gj-prog2026/BalancingRobot/hardware/pcb_kicad_ref.png

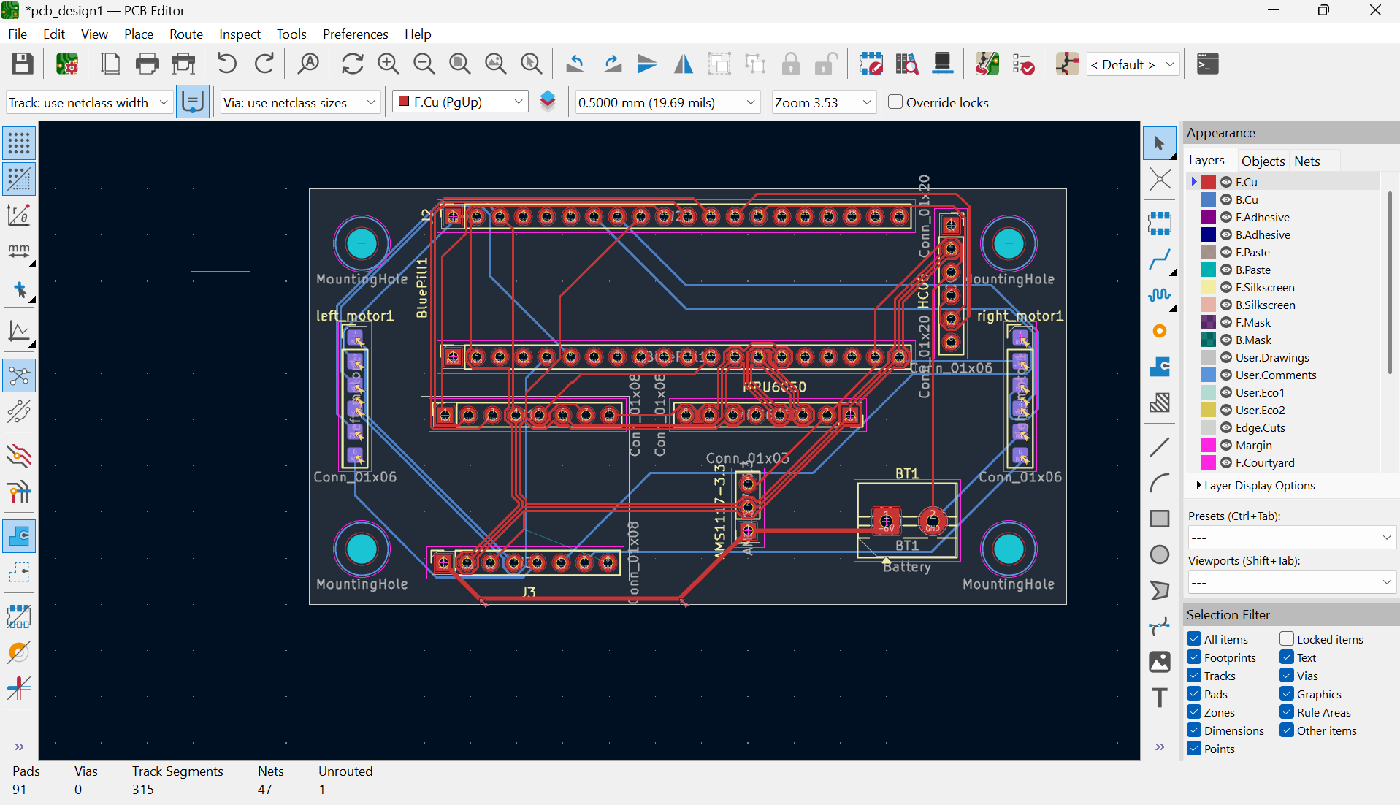
hardware/pcb_kicad_ref.png
