gj-prog2026/BalancingRobot/MATLAB_simulation/Screenshot 2026-10-11 233818.png

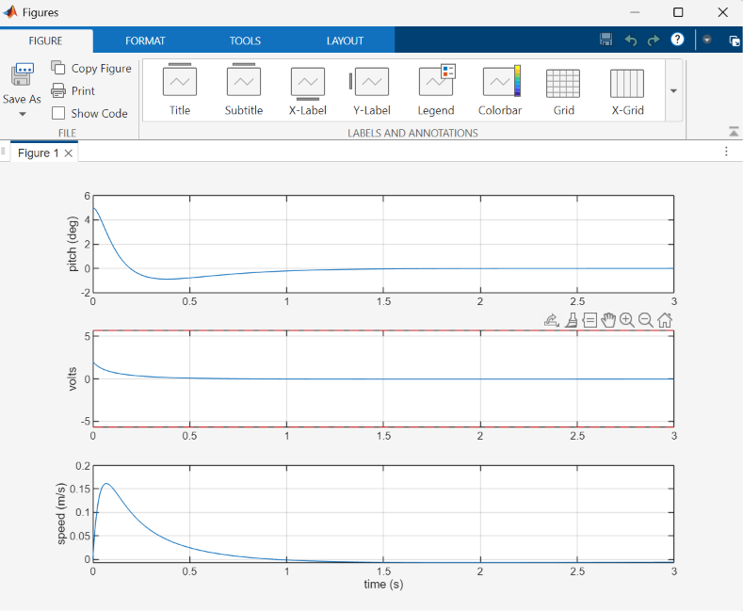
MATLAB_simulation/Screenshot 2026-10-11 233818.png
