gj-prog2026/BalancingRobot/MATLAB_simulation/Screenshot 2026-10-11 234223.png

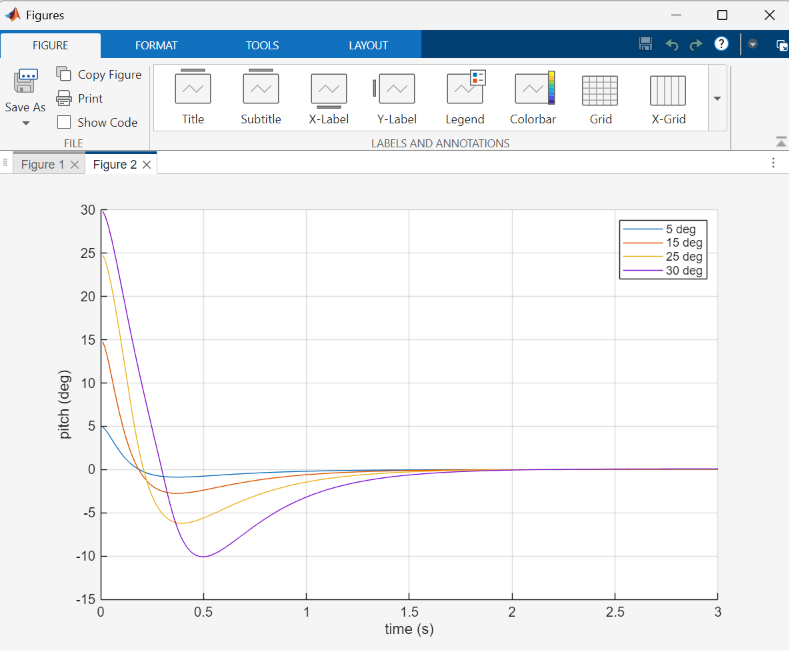
MATLAB_simulation/Screenshot 2026-10-11 234223.png
