gj-prog2026/BalancingRobot/hardware/3D_printing_parts/batt layer.stl

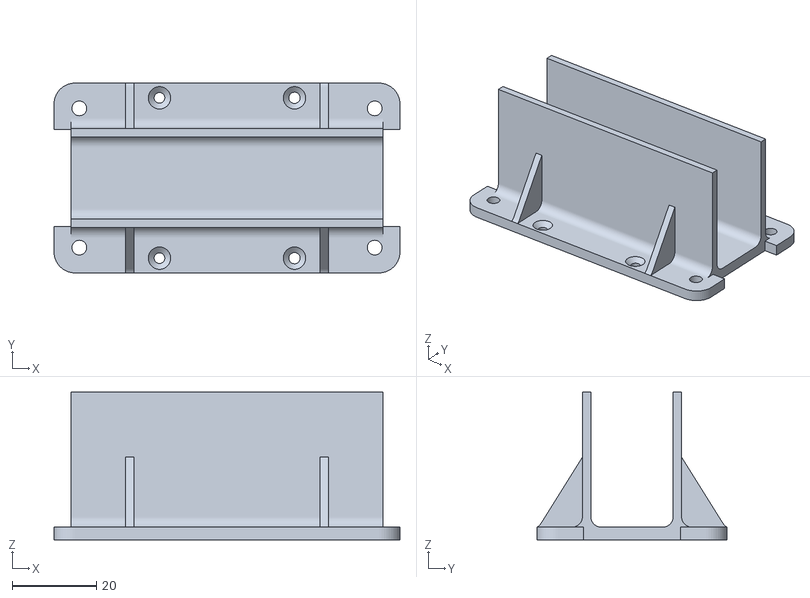
[picture p5: CAD file, 2026-09-17]
hardware/3D_printing_parts/batt layer.stl
82.0 x 45.0 x 35.0
