gj-prog2026/BalancingRobot/hardware/3D_printing_parts/base.stl

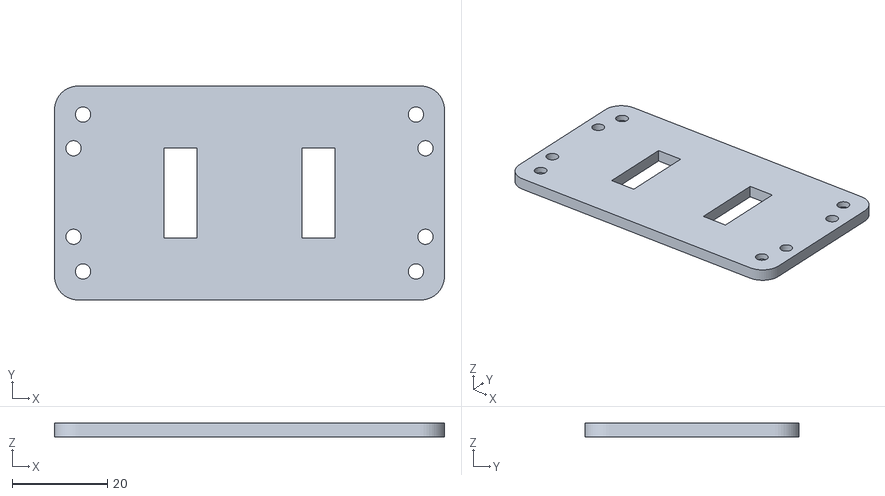
[picture p6: CAD file, 2026-09-17]
hardware/3D_printing_parts/base.stl
82.0 x 45.0 x 3.00
