gj-prog2026/BalancingRobot/hardware/3D_printing_parts/motor bracket 2.stl

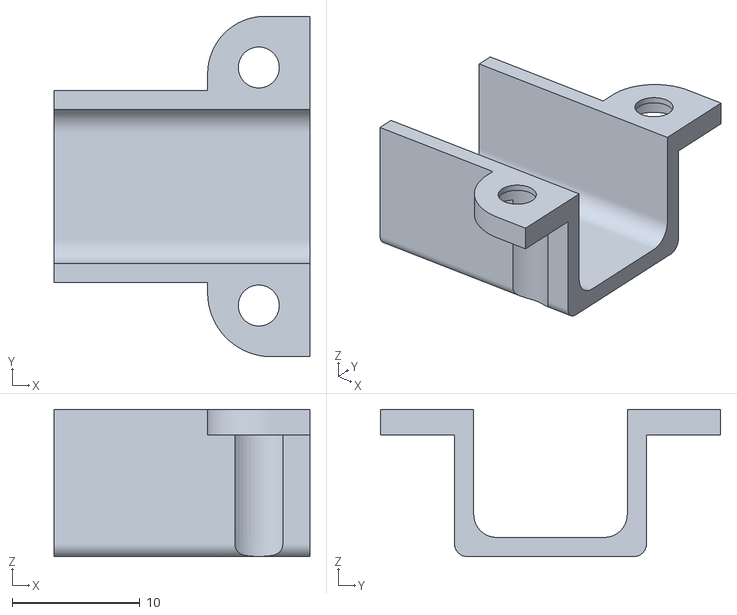
[picture p7: CAD file, 2026-09-17]
hardware/3D_printing_parts/motor bracket 2.stl
20.0 x 26.6 x 11.5
