gj-prog2026/BalancingRobot/(list of files, cad)

Other CAD files:
hardware/3D_printing_parts/motor bracket 3.stl
