gj-prog2026/BalancingRobot/software/tests_LQR/after_adjusting_gyro_accel_ratio/db_log_with_log_print1.txt

//first
LOG rel*100,acc*100,gyro*10,enc_d,pwm
8,-6,2,0,8
9,31,1,0,8
8,-98,-1,0,4
8,-66,-5,0,0
6,-71,-10,0,-6
5,-64,-15,0,-12
2,-59,-22,0,-22
-1,-170,-35,0,-39
-7,-301,-56,0,-65
-15,-368,-79,1,9976,8926,1515,-54,999
2134,-3077,1685,-52,999
2331,7513,1865,-53,999
2520,-7448,2086,-54,999
2736,-6265,2343,-54,999
2987,621,2557,-53,999
3282,8360,2847,-53,999
3605,7028,3158,-51,999
END

//second
LOG rel*100,acc*100,gyro*10,enc_d,pwm
-53,-87,-20,0,-59
-55,-67,-18,0,-59
-58,-478,-1-7870,-153,56,-999
-3058,-4318,-2330,55,-999
-3281,14402,-2584,55,-999
-3575,-7715,-2863,55,-999
-3842,16101,-3068,54,-999
-4177,-2583,-3380,55,-999
-4518,10090,-3706,55,-999
-4921,-4647,-4032,56,-999
END

//third
LOG rel*100,acc*100,gyro*10,enc_d,pwm
-358,-4001,1044,59,-878
-245,-1885,1162,60,-703
-94,9793,1317,59,-403
51,2073,1420,55,-71
196,-1702,1487,49-17189,-4251,52,-999
-3789,-8857,-4670,55,-999
-4383,-4466,-5939,58,-999
-4939,18688,-6039,61,-999
END

//forth
LOG rel*100,acc*100,gyro*10,enc_d,pwm
375,-1595,-560,7,-726
185,-5057,-1793,8,-999
-56,-4158,-2339,15,-999
-274,-3721,-2106,15,-999
-381,6146,-1202,24,-999
-452,-666,-704,28,-999
-480,-6332,-166,35,-999
-451,2560,234,38,-999
-418,-163,1449,-4,999
2239,-487,1618,-53,999
2411,-7200,1909,-55,999
2610,-1414,2076,-54,999
2842,6224,2246,-53,999
3061,-10298,2460,-54,999
3305,-12873,2760,-54,999
3613,7032,3013,-53,999
END

//fifth
LOG rel*100,acc*100,gyro*10,enc_d,pwm
-7,-26,-1,0,-7
-7,-28,-1,0,-6
-7,42,0,0,-5
-7,-182,2,0,-2
-6,-225,10,0,6
-4,-270,23,0,21
-1,-333,43,0,45
4,-451,68,0,76
13,-513,960 f307 d=595
r=-942 x=-94 v=0 p=0 f=

//conclusion: log os damaged with only 10 survivng lines to be used
// add the HAL_delay(20)
