gj-prog2026/BalancingRobot/software/tests_LQR/after_adjusting_gyro_freq/test.txt

r=-113 x=-216 v=8 p=-999 f=0 o=677 d=10
r=-82 x=-215 v=9 p=196 f=0 o=677 d=10
r=-98 x=-213 v=12 p=-768 f=0 o=677 d=10
r=-77 x=-212 v=25 p=-999 f=0 o=677 d=10
r=-67 x=-210 v=4 p=-315 f=0 o=677 d=10
r=-97 x=-209 v=23 p=-588 f=0 o=677 d=10
r=-84 x=-207 v=12 p=-878 f=0 o=677 d=10
r=-95 x=-206 v=20 p=-141 f=0 o=677 d=10
r=-60 x=-203 v=7 p=-999 f=0 o=677 d=10
r=-78 x=-201 v=28 p=136 f=0 o=677 d=10
r=-83 x=-199 v=29 p=-157 f=0 o=677 d=10
r=-76 x=-196 v=25 p=-999 f=0 o=677 d=10
r=-48 x=-193 v=34 p=-330 f=0 o=677 d=10
r=-19 x=-190 v=13 p=-167 f=0 o=677 d=10
r=-49 x=-187 v=32 p=-999 f=0 o=677 d=10
r=-41 x=-185 v=14 p=399 f=0 o=677 d=10
r=-67 x=-183 v=21 p=-999 f=0 o=677 d=10
r=-52 x=-182 v=13 p=586 f=0 o=677 d=10
r=-85 x=-180 v=18 p=-999 f=0 o=677 d=10
r=-42 x=-178 v=15 p=926 f=0 o=677 d=10
r=-53 x=-176 v=16 p=-781 f=0 o=677 d=10
r=-60 x=-175 v=10 p=82 f=0 o=677 d=10
r=-90 x=-173 v=18 p=-999 f=0 o=677 d=10
r=-78 x=-172 v=23 p=207 f=0 o=677 d=10
r=-82 x=-170 v=20 p=-999 f=0 o=677 d=10
r=-78 x=-169 v=14 p=60 f=0 o=677 d=10
r=-83 x=-167 v=26 p=-999 f=0 o=677 d=10
r=-83 x=-165 v=27 p=-919 f=0 o=677 d=10
r=-75 x=-163 v=26 p=-284 f=0 o=677 d=10
r=-54 x=-160 v=27 p=-999 f=0 o=677 d=10
r=-42 x=-158 v=19 p=-6 f=0 o=677 d=10
r=-57 x=-156 v=20 p=-999 f=0 o=677 d=10
r=-52 x=-154 v=14 p=468 f=0 o=677 d=10
r=-92 x=-151 v=32 p=-999 f=0 o=677 d=10
r=-56 x=-149 v=11 p=212 f=0 o=677 d=10
r=-74 x=-147 v=17 p=-999 f=0 o=677 d=10
r=-48 x=-144 v=15 p=-999 f=0 o=677 d=10
r=-70 x=-142 v=24 p=-123 f=0 o=677 d=10
r=-69 x=-140 v=16 p=-999 f=0 o=677 d=10
r=-37 x=-137 v=8 p=999 f=0 o=677 d=10
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
