gj-prog2026/BalancingRobot/software/tests_LQR/sign_test/result_log.txt

rel*10=956 gyro*10=0 pwm=0
rel*10=956 gyro*10=0 pwm=0
rel*10=956 gyro*10=2 pwm=0
rel*10=956 gyro*10=1 pwm=0
rel*10=956 gyro*10=0 pwm=0
rel*10=956 gyro*10=0 pwm=0
rel*10=956 gyro*10=0 pwm=0
rel*10=956 gyro*10=0 pwm=0
rel*10=956 gyro*10=0 pwm=0
rel*10=956 gyro*10=0 pwm=0
rel*10=956 gyro*10=0 pwm=0
rel*10=955 gyro*10=-4 pwm=0
rel*10=955 gyro*10=-5 pwm=0
rel*10=955 gyro*10=0 pwm=0
rel*10=955 gyro*10=1 pwm=0
rel*10=956 gyro*10=3 pwm=0
rel*10=956 gyro*10=5 pwm=0
rel*10=956 gyro*10=1 pwm=0
rel*10=956 gyro*10=0 pwm=0
rel*10=956 gyro*10=0 pwm=0
rel*10=956 gyro*10=-8 pwm=0
rel*10=956 gyro*10=1 pwm=0
rel*10=956 gyro*10=0 pwm=0
rel*10=955 gyro*10=1 pwm=0
rel*10=955 gyro*10=0 pwm=0
rel*10=956 gyro*10=0 pwm=0
rel*10=956 gyro*10=0 pwm=0
rel*10=956 gyro*10=0 pwm=0
rel*10=955 gyro*10=0 pwm=0
rel*10=955 gyro*10=0 pwm=0
rel*10=955 gyro*10=-2 pwm=0
rel*10=955 gyro*10=-9 pwm=0
rel*10=951 gyro*10=-70 pwm=0
rel*10=944 gyro*10=-8 pwm=0
rel*10=943 gyro*10=-10 pwm=0
rel*10=940 gyro*10=-76 pwm=0
rel*10=924 gyro*10=-174 pwm=0
rel*10=901 gyro*10=-318 pwm=0
rel*10=855 gyro*10=-544 pwm=0
rel*10=804 gyro*10=-514 pwm=0
rel*10=759 gyro*10=-491 pwm=0
rel*10=702 gyro*10=-543 pwm=0
rel*10=648 gyro*10=-528 pwm=0
rel*10=596 gyro*10=-527 pwm=0
rel*10=545 gyro*10=-518 pwm=0
rel*10=491 gyro*10=-546 pwm=0
rel*10=424 gyro*10=-714 pwm=0
rel*10=339 gyro*10=-779 pwm=0
rel*10=266 gyro*10=-598 pwm=0
rel*10=178 gyro*10=-865 pwm=0
rel*10=77 gyro*10=-857 pwm=0
rel*10=22 gyro*10=-317 pwm=0
rel*10=19 gyro*10=36 pwm=0
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
rel*10=313 gyro*10=463 pwm=0
rel*10=373 gyro*10=755 pwm=0
rel*10=466 gyro*10=925 pwm=0
rel*10=572 gyro*10=1058 pwm=0
rel*10=680 gyro*10=921 pwm=0
rel*10=776 gyro*10=887 pwm=0
rel*10=835 gyro*10=355 pwm=0
rel*10=865 gyro*10=288 pwm=0
rel*10=892 gyro*10=261 pwm=0
rel*10=932 gyro*10=1043 pwm=0
rel*10=912 gyro*10=35 pwm=0
rel*10=922 gyro*10=0 pwm=0
rel*10=929 gyro*10=6 pwm=0
rel*10=934 gyro*10=24 pwm=0
rel*10=939 gyro*10=0 pwm=0
rel*10=941 gyro*10=9 pwm=0
rel*10=945 gyro*10=0 pwm=0
rel*10=947 gyro*10=-6 pwm=0
rel*10=950 gyro*10=-8 pwm=0
rel*10=952 gyro*10=-3 pwm=0
rel*10=953 gyro*10=-1 pwm=0
rel*10=954 gyro*10=0 pwm=0
rel*10=956 gyro*10=1 pwm=0
rel*10=956 gyro*10=1 pwm=0
