gj-prog2026/BalancingRobot/software/tests_PID/pid_tuning_log/tuning_pid1.txt

rel_pitch=19.55 Kp=15.00 Ki=0.50 Kd=0.30 motors=1
rel_pitch=7.18 Kp=15.00 Ki=0.50 Kd=0.30 motors=1
rel_pitch=-9.03 Kp=15.00 Ki=0.50 Kd=0.30 motors=1
rel_pitch=0.99 Kp=15.00 Ki=0.50 Kd=0.30 motors=1
rel_pitch=4.78 Kp=15.00 Ki=0.50 Kd=0.30 motors=1
rel_pitch=2.84 Kp=15.00 Ki=0.50 Kd=0.30 motors=1
rel_pitch=0.68 Kp=15.00 Ki=0.50 Kd=0.30 motors=1
rel_pitch=5.54 Kp=15.00 Ki=0.50 Kd=0.30 motors=1
rel_pitch=25.51 Kp=15.00 Ki=0.50 Kd=0.30 motors=1
rel_pitch=26.94 Kp=15.00 Ki=0.50 Kd=0.30 motors=1
rel_pitch=29.39 Kp=15.00 Ki=0.50 Kd=0.30 motors=1
rel_pitch=31.61 Kp=15.00 Ki=0.50 Kd=0.30 motors=0
rel_pitch=3.73 Kp=15.00 Ki=0.50 Kd=0.30 motors=0
rel_pitch=-12.04 Kp=15.00 Ki=0.50 Kd=0.30 motors=0
rel_pitch=1.51 Kp=15.00 Ki=0.50 Kd=0.30 motors=0
rel_pitch=7.04 Kp=15.00 Ki=0.50 Kd=0.30 motors=0
rel_pitch=19.67 Kp=15.00 Ki=0.50 Kd=0.30 motors=0
rel_pitch=25.22 Kp=15.00 Ki=0.50 Kd=0.30 motors=0
rel_pitch=31.31 Kp=15.00 Ki=0.50 Kd=0.30 motors=0
rel_pitch=31.97 Kp=15.00 Ki=0.50 Kd=0.30 motors=0
rel_pitch=29.46 Kp=15.00 Ki=0.50 Kd=0.30 motors=0
rel_pitch=32.85 Kp=15.00 Ki=0.50 Kd=0.30 motors=0
rel_pitch=30.62 Kp=15.00 Ki=0.50 Kd=0.30 motors=0
rel_pitch=37.19 Kp=15.00 Ki=0.50 Kd=0.30 motors=0
rel_pitch=32.33 Kp=15.00 Ki=0.50 Kd=0.30 motors=0
rel_pitch=28.69 Kp=15.00 Ki=0.50 Kd=0.30 motors=0
rel_pitch=24.55 Kp=15.00 Ki=0.50 Kd=0.30 motors=0
rel_pitch=21.40 Kp=15.00 Ki=0.50 Kd=0.30 motors=0
rel_pitch=19.80 Kp=15.00 Ki=0.50 Kd=0.30 motors=0
rel_pitch=18.88 Kp=15.00 Ki=0.50 Kd=0.30 motors=0
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
rel_pitch=99.65 Kp=15.00 Ki=0.50 Kd=0.30 motors=0
rel_pitch=117.66 Kp=15.00 Ki=0.50 Kd=0.30 motors=0
rel_pitch=132.32 Kp=15.00 Ki=0.50 Kd=0.30 motors=0
rel_pitch=144.01 Kp=15.00 Ki=0.50 Kd=0.30 motors=0
rel_pitch=153.28 Kp=15.00 Ki=0.50 Kd=0.30 motors=0
rel_pitch=160.07 Kp=15.00 Ki=0.50 Kd=0.30 motors=0
rel_pitch=166.02 Kp=15.00 Ki=0.50 Kd=0.30 motors=0
rel_pitch=169.36 Kp=15.00 Ki=0.50 Kd=0.30 motors=0
rel_pitch=170.93 Kp=15.00 Ki=0.50 Kd=0.30 motors=0
rel_pitch=171.85 Kp=15.00 Ki=0.50 Kd=0.30 motors=0
rel_pitch=172.73 Kp=15.00 Ki=0.50 Kd=0.30 motors=0
rel_pitch=173.28 Kp=15.00 Ki=0.50 Kd=0.30 motors=0
rel_pitch=173.33 Kp=15.00 Ki=0.50 Kd=0.30 motors=0
rel_pitch=173.34 Kp=15.00 Ki=0.50 Kd=0.30 motors=0
rel_pitch=173.60 Kp=15.00 Ki=0.50 Kd=0.30 motors=0
rel_pitch=173.80 Kp=15.00 Ki=0.50 Kd=0.30 motors=0
rel_pitch=173.96 Kp=15.00 Ki=0.50 Kd=0.30 motors=0
rel_pitch=174.03 Kp=15.00 Ki=0.50 Kd=0.30 motors=0
rel_pitch=174.05 Kp=15.00 Ki=0.50 Kd=0.30 motors=0
rel_pitch=174.12 Kp=15.00 Ki=0.50 Kd=0.30 motors=0
