gj-prog2026/BalancingRobot/software/tests_PID/pid_tuning_log/tuning_pid10.txt

relh=-157.67 raw(ax,ay,az)=-552,-168,-16000 Kp=20.00 Ki=0.10 Kd=0.40 motors=0
rel_pitch=-157.67 raw(ax,ay,az)=-616,-88,-16080 Kp=20.00 Ki=0.10 Kd=0.40 motors=0
rel_pitch=-157.71 raw(ax,ay,az)=-528,8,-16088 Kp=20.00 Ki=0.10 Kd=0.40 motors=0
rel_pitch=-157.70 raw(ax,ay,az)=-440,-72,-15896 Kp=20.00 Ki=0.10 Kd=0.40 motors=0
rel_pitch=-157.69 raw(ax,ay,az)=-648,-80,-16088 Kp=20.00 Ki=0.10 Kd=0.40 motors=0
rel_pitch=-157.69 raw(ax,ay,az)=-640,8,-16032 Kp=20.00 Ki=0.10 Kd=0.40 motors=0
rel_pitch=-157.71 raw(ax,ay,az)=-560,64,-16016 Kp=20.00 Ki=0.10 Kd=0.40 motors=0
rel_pitch=-157.71 raw(ax,ay,az)=-608,-120,-16072 Kp=20.00 Ki=0.10 Kd=0.40 motors=0
rel_pitch=-157.71 raw(ax,ay,az)=-536,64,-15968 Kp=20.00 Ki=0.10 Kd=0.40 motors=0
rel_pitch=-157.72 raw(ax,ay,az)=-600,-56,-16112 Kp=20.00 Ki=0.10 Kd=0.40 motors=0
rel_pitch=-157.67 raw(ax,ay,az)=-712,96,-16024 Kp=20.00 Ki=0.10 Kd=0.40 motors=0
rel_pitch=-157.67 raw(ax,ay,az)=-632,-152,-16040 Kp=20.00 Ki=0.10 Kd=0.40 motors=0
rel_pitch=-157.67 raw(ax,ay,az)=-512,48,-16040 Kp=20.00 Ki=0.10 Kd=0.40 motors=0
rel_pitch=-157.70 raw(ax,ay,az)=-544,-24,-15936 Kp=20.00 Ki=0.10 Kd=0.40 motors=0
rel_pitch=-157.70 raw(ax,ay,az)=-576,-16,-16016 Kp=20.00 Ki=0.10 Kd=0.40 motors=0
rel_pitch=-157.70 raw(ax,ay,az)=-632,-8,-16064 Kp=20.00 Ki=0.10 Kd=0.40 motors=0
rel_pitch=-157.71 raw(ax,ay,az)=-656,-48,-16128 Kp=20.00 Ki=0.10 Kd=0.40 motors=0
rel_pitch=-157.68 raw(ax,ay,az)=-576,-72,-15968 Kp=20.00 Ki=0.10 Kd=0.40 motors=0
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
rel_pitch=-22.21 raw(ax,ay,az)=-10840,-14184,13224 Kp=20.00 Ki=0.10 Kd=0.40 motors=1
rel_pitch=-21.77 raw(ax,ay,az)=-7912,-16664,9368 Kp=20.00 Ki=0.10 Kd=0.40 motors=1
rel_pitch=-19.98 raw(ax,ay,az)=-5456,-14336,12136 Kp=20.00 Ki=0.10 Kd=0.40 motors=1
rel_pitch=-18.49 raw(ax,ay,az)=-6696,-17480,10600 Kp=20.00 Ki=0.10 Kd=0.40 motors=1
rel_pitch=-14.02 raw(ax,ay,az)=-1112,-15456,12256 Kp=20.00 Ki=0.10 Kd=0.40 motors=1
rel_pitch=-6.89 raw(ax,ay,az)=2872,-1216,16880 Kp=20.00 Ki=0.10 Kd=0.40 motors=1
rel_pitch=-1.11 raw(ax,ay,az)=496,-176,17152 Kp=20.00 Ki=0.10 Kd=0.40 motors=1
rel_pitch=2.19 raw(ax,ay,az)=-928,-1128,17208 Kp=20.00 Ki=0.10 Kd=0.40 motors=1
rel_pitch=4.70 raw(ax,ay,az)=-1632,-2584,16472 Kp=20.00 Ki=0.10 Kd=0.40 motors=1
rel_pitch=5.70 raw(ax,ay,az)=-3368,-1408,15880 Kp=20.00 Ki=0.10 Kd=0.40 motors=1
rel_pitch=6.68 raw(ax,ay,az)=-2992,-3272,15704 Kp=20.00 Ki=0.10 Kd=0.40 motors=1
rel_pitch=7.52 raw(ax,ay,az)=-2992,-824,16152 Kp=20.00 Ki=0.10 Kd=0.40 motors=1
rel_pitch=7.57 raw(ax,ay,az)=-3280,-1696,12768 Kp=20.00 Ki=0.10 Kd=0.40
