gj-prog2026/BalancingRobot/software/tests_PID/pid_tuning_log/tuning_pid11.txt

reh=-157.38 raw(ax,ay,az)=-720,-376,-16104 Kp=8.00 Ki=0.10 Kd=0.40 motors=0
rel_pitch=-157.38 raw(ax,ay,az)=-712,-392,-15984 Kp=8.00 Ki=0.10 Kd=0.40 motors=0
rel_pitch=-157.38 raw(ax,ay,az)=-696,-240,-16112 Kp=8.00 Ki=0.10 Kd=0.40 motors=0
rel_pitch=-157.38 raw(ax,ay,az)=-648,-432,-16040 Kp=8.00 Ki=0.10 Kd=0.40 motors=0
rel_pitch=-157.36 raw(ax,ay,az)=-848,-296,-16032 Kp=8.00 Ki=0.10 Kd=0.40 motors=0
rel_pitch=-157.35 raw(ax,ay,az)=-704,-312,-15976 Kp=8.00 Ki=0.10 Kd=0.40 motors=0
rel_pitch=-157.32 raw(ax,ay,az)=-720,-376,-16080 Kp=8.00 Ki=0.10 Kd=0.40 motors=0
rel_pitch=-157.34 raw(ax,ay,az)=-864,-168,-15928 Kp=8.00 Ki=0.10 Kd=0.40 motors=0
rel_pitch=-157.34 raw(ax,ay,az)=-736,-392,-16160 Kp=8.00 Ki=0.10 Kd=0.40 motors=0
rel_pitch=-157.32 raw(ax,ay,az)=-736,-264,-16040 Kp=8.00 Ki=0.10 Kd=0.40 motors=0
rel_pitch=-157.27 raw(ax,ay,az)=-872,-488,-16040 Kp=8.00 Ki=0.10 Kd=0.40 motors=0
rel_pitch=-157.27 raw(ax,ay,az)=-704,-368,-16016 Kp=8.00 Ki=0.10 Kd=0.40 motors=0
rel_pitch=-157.26 raw(ax,ay,az)=-728,-344,-16000 Kp=8.00 Ki=0.10 Kd=0.40 motors=0
rel_pitch=-157.25 raw(ax,ay,az)=-632,-336,-16024 Kp=8.00 Ki=0.10 Kd=0.40 motors=0
rel_pitch=-157.24 raw(ax,ay,az)=-904,-280,-16128 Kp=8.00 Ki=0.10 Kd=0.40 motors=0
rel_pitch=-157.20 raw(ax,ay,az)=-800,-328,-16032 Kp=8.00 Ki=0.10 Kd=0.40 motors=0
rel_pitch=-157.22 raw(ax-696,-424,-16064 Kp=8.00 Ki=0.10 Kd=0.40 motors=0
rel_pitch=-157.22 raw(ax,ay,az)=-824,-328,-15968 Kp=8.00 Ki=0.10 Kd=0.40 motors=0
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
rel_pitch=-118.34 raw(ax,ay,az)=-7160,272,-15608 Kp=8.00 Ki=0.10 Kd=0.40 motors=0
rel_pitch=-124.29 raw(ax,ay,az)=-2600,-56,-15616 Kp=8.00 Ki=0.10 Kd=0.40 motors=0
rel_pitch=-130.12 raw(ax,ay,az)=-1096,1056,-15384 Kp=8.00 Ki=0.10 Kd=0.40 motors=0
