gj-prog2026/BalancingRobot/software/tests_PID/pid_tuning_log/tuning_pid12.txt

rel_pitch=-66.99 raw(ax,ay,az)=-16480,-2944,800 Kp=9.00 Ki=0.10 Kd=0.70 motors=1
rel_pitch=-66.99 raw(ax,ay,az)=-16192,-1816,1240 Kp=9.00 Ki=0.10 Kd=0.70 motors=1
rel_pitch=-66.25 raw(ax,ay,az)=-15936,-24,2176 Kp=9.00 Ki=0.10 Kd=0.70 motors=1
rel_pitch=-65.59 raw(ax,ay,az)=-16600,1120,2104 Kp=9.00 Ki=0.10 Kd=0.70 motors=1
rel_pitch=-65.24 raw(ax,ay,az)=-16152,-288,1824 Kp=9.00 Ki=0.10 Kd=0.70 motors=1
rel_pitch=-65.25 raw(ax,ay,az)=-16256,-2312,1120 Kp=9.00 Ki=0.10 Kd=0.70 motors=1
rel_pitch=-65.74 raw(ax,ay,az)=-16600,-1880,512 Kp=9.00 Ki=0.10 Kd=0.70 motors=1
rel_pitch=-65.88 raw(ax,ay,az)=-15688,288,1016 Kp=9.00 Ki=0.10 Kd=0.70 motors=1
rel_pitch=-66.66 raw(ax,ay,az)=-16200,1024,-800 Kp=9.00 Ki=0.10 Kd=0.70 motors=1
rel_pitch=-72.75 raw(ax,ay,az)=-12264,-3640,-9416 Kp=9.00 Ki=0.10 Kd=0.70 motors=1
rel_pitch=-78.56ay,az)=-15960,-3960,-11216 Kp=9.00 Ki=0.10 Kd=0.70 motors=1
rel_pitch=-81.69 raw(ax,ay,az)=-13888,1280,-4568 Kp=9.00 Ki=0.10 Kd=0.70 motors=1
rel_pitch=-80.58 raw(ax,ay,az)=-16584,3632,-1056 Kp=9.00 Ki=0.10 Kd=0.70 motors=1
rel_pitch=-78.36 raw(ax,ay,az)=-15088,928,784 Kp=9.00 Ki=0.10 Kd=0.70 motors=1
rel_pitch=-76.89 raw(ax,ay,az)=-16408,-4728,-840 Kp=9.00 Ki=0.10 Kd=0.70 motors=1
rel_pitch=-76.10 raw(ax,ay,az)=-16248,-3152,-1992 Kp=9.00 Ki=0.10 Kd=0.70 motors=1
rel_pitch=-73.71 raw(ax,ay,az)=-16456,1264,5224 Kp=9.00 Ki=0.10 Kd=0.70 motors=1
rel_pitch=-71.63 raw(ax,ay,az)=-16632,2744,2240 Kp=9.00 Ki=0.10 Kd=0.70 motors=1
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
rel_pitch=-66.28 raw(ax,ay,az)=-16416,688,880 Kp=14.00 Ki=0.70 Kd=0.70 motors=1
rel_pitch=-66.88 raw(ax,ay,az)=-17000,-3664,136 Kp=14.00 Ki=0.70 Kd=0.70 motors=1
rel_pitch=-67.51 raw(ax,ay,az)=-16448,-2800,256 Kp=14.00 Ki=0.70 Kd=0.70 motors=1
