gj-prog2026/BalancingRobot/software/tests_PID/pid_tuning_log/tuning_pid13.txt

=1
rel_pitch=-73.78 raw(ax,ay,az)=-16440,-8568,-1136 Kp=14.00 Ki=0.00 Kd=0.00 motors=1
rel_pitch=-72.79 raw(ax,ay,az)=-14808,2520,7176 Kp=14.00 Ki=0.00 Kd=0.00 motors=1
rel_pitch=-70.92 raw(ax,ay,az)=-14608,2600,24 Kp=14.00 Ki=0.00 Kd=0.00 motors=1
rel_pitch=-71.45 raw(ax,ay,az)=-16320,-5224,-32 Kp=14.00 Ki=0.00 Kd=0.00 motors=1
rel_pitch=-71.77 raw(ax,ay,az)=-17128,-4408,-16 Kp=14.00 Ki=0.00 Kd=0.00 motors=1
rel_pitch=-71.71 raw(ax,ay,az)=-15816,4056,-616 Kp=14.00 Ki=0.00 Kd=0.00 motors=1
rel_pitch=-71.00 raw(ax,ay,az)=-16240,624,712 Kp=14.00 Ki=0.00 Kd=0.00 motors=1
rel_pitch=-72.01 raw(ax,ay,az)=-16936,-3880,-1768 Kp=14.00 Ki=0.00 Kd=0.00 motors=1
rel_pitch=-73.91 raw(ax,ay,az)=-12856,-2168,-5232 Kp=14.00 Ki=0.00 Kd=0.00 motors=1
rel_pitch=-75.25 raw(ax,ay,az)=-15632,9520,-456 Kp=14.00 Ki=0.00 Kd=0.00 motors=1
rel_pitch=-76.12 raw(ax,ay,az)=-16552,664,-2456 Kp=14.00 Ki=0.00 Kd=0.00 motors=1
rel_pitch=-78.09 raw(ax,ay,az)=-17344,-6432,-6424 Kp=14.00 Ki=0.00 Kd=0.00 motors=1
rel_pitch=-80.19 raw(ax,ay,az)=-14440,-8040,-2624 Kp=14.00 Ki=0.00 Kd=0.00 motors=1
rel_pitch=-77.80 raw(ax,ay,az)=-14608,7592,1144 Kp=14.00 Ki=0.00 Kd=0.00 motors=1
rel_pitch=-76.14 raw(ax,ay,az)=-14416,-976,-1936 Kp=14.00 Ki=0.00 Kd=0.00 motors=1
rel_pitch=-75.90 raw(ax,ay,az)=-16104,-4776,-5384 Kp=14.00 Ki=0.00 Kd=0.00 motors=1
rel_pitch=-76.34 raw(ax,ay,az)=-17072,-8208,-1984 Kp=14.00 Ki=0.00 Kd=0.00 motors=1
rel_pitch=-73.29 raw(ax,ay,az)=-18312,1192,5048 Kp=14.00 Ki=0.00 Kd=0.00 motors=1
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
rel_pitch=-63.23 raw(ax,ay,az)=-16216,-1336,728 Kp=20.00 Ki=0.00 Kd=0.00 motors=1
rel_pitch=-64.02 raw(ax,ay,az)=-16040,-1264,432 Kp=20.00 Ki=0.00 Kd=0.00 motors=1
rel_pitch=-64.96 raw(ax,ay,az)=-15944,-648,624 Kp=20.00 Ki=0.00 Kd=0.00 motors=1
rel_pitch=-65.38 raw(ax,ay,az)=-16040,-256,512 Kp=20.00 Ki=0.00 Kd=0.00 motors=1
rel_pitch=-65.19 raw(ax,ay,az)=-15504,-1056,1336 Kp=20.00 Ki=0.00 Kd=0.00 motors=1
rel_pitch=-65.26 raw(ax,ay,az)=-15848,240,144 Kp=20.00 Ki=0.00 Kd=0.00 motors=1
