gj-prog2026/BalancingRobot/software/tests_PID/pid_tuning_log/tuning_pid14.txt

96,-15976 Kp=8.00 Ki=0.10 Kd=0.70 motors=0
rel_pitch=-158.32 pwm=0 raw(ax,ay,az)=-512,-200,-15832 Kp=8.00 Ki=0.10 Kd=0.70 motors=0
rel_pitch=-158.35 pwm=0 raw(ax,ay,az)=-504,-32,-15984 Kp=8.00 Ki=0.10 Kd=0.70 motors=0
rel_pitch=-158.41 pwm=0 raw(ax,ay,az)=-320,-224,-15904 Kp=8.00 Ki=0.10 Kd=0.70 motors=0
rel_pitch=-158.48 pwm=0 raw(ax,ay,az)=-448,-416,-15984 Kp=8.00 Ki=0.10 Kd=0.70 motors=0
rel_pitch=-158.47 pwm=0 raw(ax,ay,az)=-408,-136,-15944 Kp=8.00 Ki=0.10 Kd=0.70 motors=0
rel_pitch=-158.47 pwm=0 raw(ax,ay,az)=-336,-136,-15952 Kp=8.00 Ki=0.10 Kd=0.70 motors=0
rel_pitch=-158.49 pwm=0 raw(ax,ay,az)=-368,-200,-16104 Kp=8.00 Ki=0.10 Kd=0.70 motors=0
rel_pitch=-158.54 pwm=0 raw(ax,ay,az)=-264,-128,-16000 Kp=8.00 Ki=0.10 Kd=0.70 motors=0
rel_pitch=-144.35 pwm=0 raw(ax,ay,az)=128,-48,-16536 Kp=8.00 Ki=0.10 Kd=0.70 motors=0
rel_pitch=-146.91 pwm=0 raw(ax,ay,az)=-336,-176,-15888 Kp=8.00 Ki=0.10 Kd=0.70 motors=0
rel_pitch=-149.01 pwm=0 raw(ax,ay,az)=-448,-296,-15896 Kp=8.00 Ki=0.10 Kd=0.70 motors=0
rel_pitch=-150.75 pwm=0 raw(ax,ay,az)=-400,-256,-15928 Kp=8.00 Ki=0.10 Kd=0.70 motors=0
rel_pitch=-152.16 pwm=0 raw(ax,ay,az)=-496,-192,-15848 Kp=8.00 Ki=0.10 Kd=0.70 motors=0
rel_pitch=-153.31 pwm=0 raw(ax,ay,az)=-464,-440,-15768 Kp=8.00 Ki=0.10 Kd=0.70 motors=0
rel_pitch=-154.26 pwm=0 raw(ax,ay,az)=-472,-136,-15864 Kp=8.00 Ki=0.10 Kd=0.70 motors=0
rel_pitch=-155.05 pwm=0 raw(ax,ay,az)=-456,-224,-15984 Kp=8.00 Ki=0.10 Kd=0.70 motors=0
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
rel_pitch=-47.38 pwm=-92 raw(ax,ay,az)=-16712,-1856,792 Kp=8.00 Ki=0.10 Kd=0.70 motors=1
rel_pitch=-49.59 pwm=-85 raw(ax,ay,az)=-15752,-112,2288 Kp=8.00 Ki=0.10 Kd=0.70 motors=1
rel_pitch=-52.78 pwm=-56 raw(ax,ay,az)=-17440,-1248,1200 Kp=8.00 Ki=0.10 Kd=0.70 motors=1
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
