gj-prog2026/BalancingRobot/hardware/pcb_design1/pcb_design1.kicad_pcb

## KiCad design hardware/pcb_design1/pcb_design1.kicad_pcb (2026-09-17)

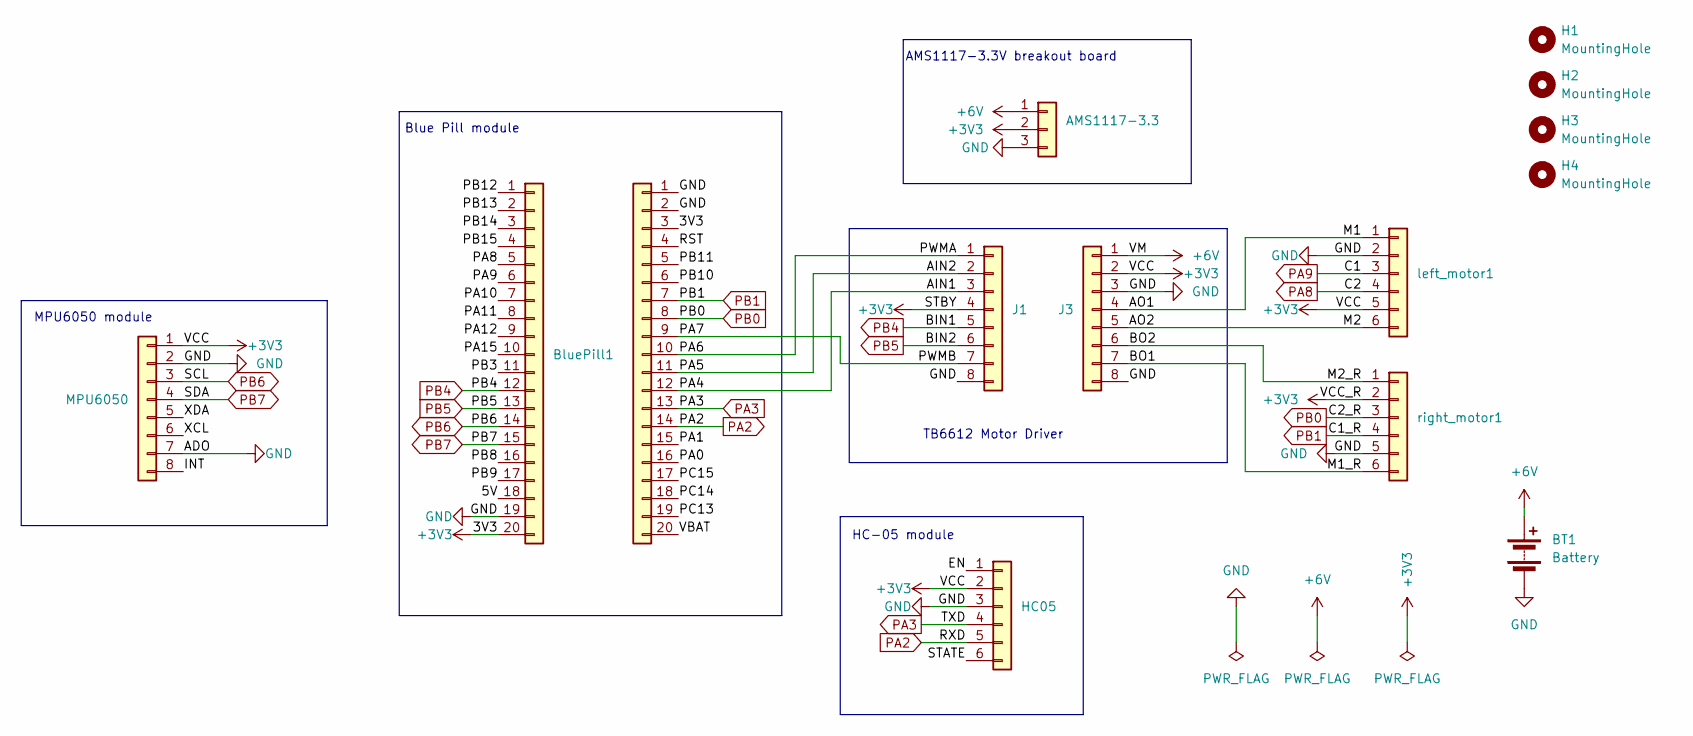
[picture p9: schematic pcb_design1.kicad_sch, PCB design for Balanging Bot]

Parts:
AMS1117-3.3: Conn_01x03; PinSocket_1x03_P2.54mm_Vertical
BT1: Battery; TerminalBlock_MaiXu_MX126-5.0-02P_1x02_P5.00mm
BluePill1: Conn_01x20; PinSocket_1x20_P2.54mm_Vertical
H1, H2, H3, H4: MountingHole; MountingHole_3.2mm_M3_ISO7380
HC05: Conn_01x06; PinSocket_1x06_P2.54mm_Vertical
J1, J3: Conn_01x08; PinSocket_1x08_P2.54mm_Vertical
J2: Conn_01x20; PinSocket_1x20_P2.54mm_Vertical
MPU6050: Conn_01x08; PinSocket_1x08_P2.54mm_Vertical
left_motor1: Conn_01x06; PinHeader_1x06_P2.54mm_Vertical
right_motor1: Conn_01x06; PinHeader_1x06_P2.54mm_Vertical

Connections:
+3V3: AMS1117-3.3.2, BluePill1.20, HC05.2, J1.4, J2.3, J3.2, MPU6050.1, left_motor1.5, right_motor1.2; also elsewhere on the board
+6V: AMS1117-3.3.1, BT1.1 (+), J3.1; also elsewhere on the board
/5V: BluePill1.18
/AIN1: J1.3, J2.12
/AIN2: J1.2, J2.11
/AO1: J3.4, left_motor1.1; also elsewhere on the board
/AO2: J3.5, left_motor1.6; also elsewhere on the board
/BO1: J3.7, right_motor1.6; also elsewhere on the board
/BO2: J3.6, right_motor1.1; also elsewhere on the board
/EN: HC05.1
/INT: MPU6050.8
/PA0: J2.16
/PA1: J2.15
/PA6: J1.1, J2.10
/PA7: J1.7, J2.9
/PA10: BluePill1.7
/PA11: BluePill1.8
/PA12: BluePill1.9
/PA15: BluePill1.10
/PB3: BluePill1.11
/PB8: BluePill1.16
/PB9: BluePill1.17
/PB10: J2.6
/PB11: J2.5
/PB12: BluePill1.1
/PB13: BluePill1.2
/PB14: BluePill1.3
/PB15: BluePill1.4
/PC13: J2.19
/PC14: J2.18
/PC15: J2.17
/RST: J2.4
/STATE: HC05.6
/VBAT: J2.20
/XCL: MPU6050.6
/XDA: MPU6050.5
GND: AMS1117-3.3.3, BT1.2 (-), BluePill1.19, HC05.3, J1.8, J2.1, J2.2, J3.3, J3.8, MPU6050.2, MPU6050.7, left_motor1.2, right_motor1.5; also elsewhere on the board
PA2: HC05.5, J2.14
PA3: HC05.4, J2.13
PA8: BluePill1.5, left_motor1.4
PA9: BluePill1.6, left_motor1.3
PB0: J2.8, right_motor1.3
PB1: J2.7, right_motor1.4
PB4: BluePill1.12, J1.5
PB5: BluePill1.13, J1.6
PB6: BluePill1.14, MPU6050.3
PB7: BluePill1.15, MPU6050.4

Notes on the sheet:
AMS1117-3.3V breakout board
MPU6050 module
TB6612 Motor Driver
HC-05 module
Blue Pill module

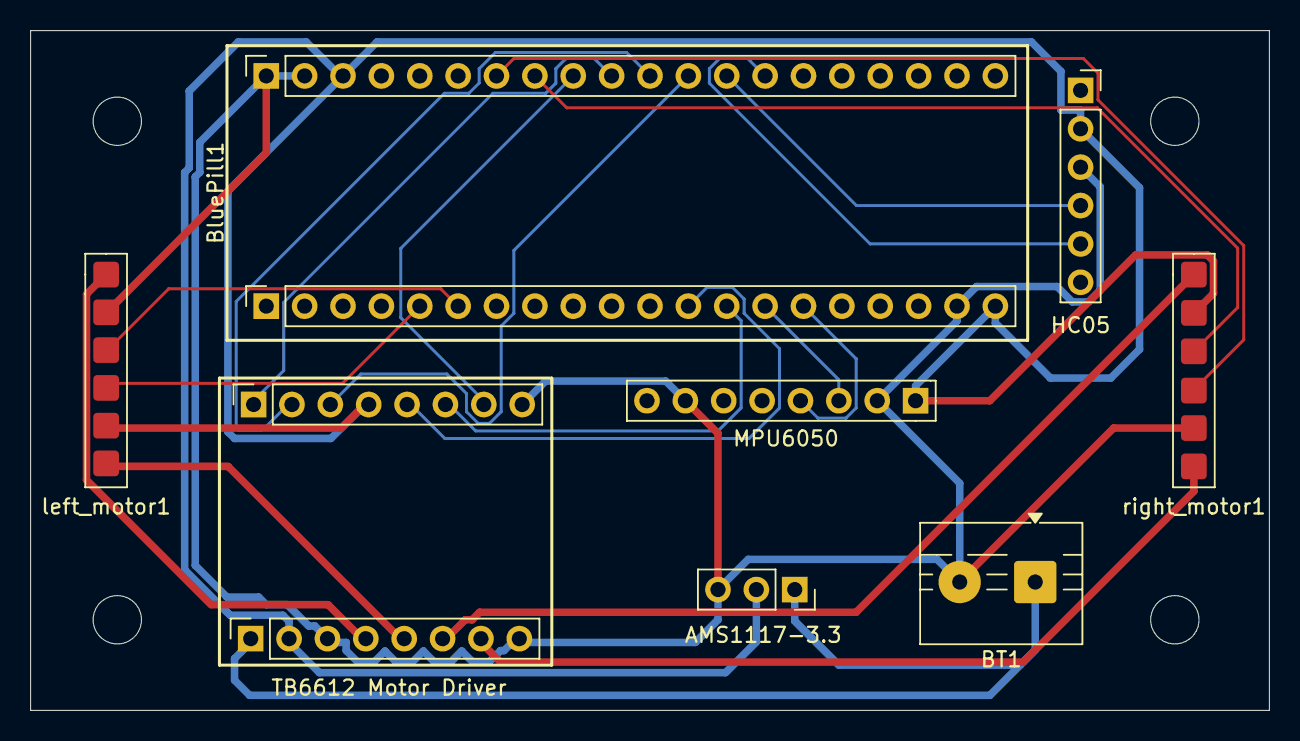
[picture p10: board pcb_design1.kicad_pcb from above]

Board: 2 copper layers, 82.0 x 45.0 mm, 14 parts (0 on the bottom side), 21 nets.

Other parts of the board:
TB6612 Motor Driver: Conn_01x08; PinSocket_1x08_P2.54mm_Vertical

Their connections:
+3V3: TB6612 Motor Driver.2; also elsewhere on the board
+6V: TB6612 Motor Driver.1; also elsewhere on the board
/AO1: TB6612 Motor Driver.4; also elsewhere on the board
/AO2: TB6612 Motor Driver.5; also elsewhere on the board
/BO1: TB6612 Motor Driver.7; also elsewhere on the board
/BO2: TB6612 Motor Driver.6; also elsewhere on the board
GND: TB6612 Motor Driver.3, TB6612 Motor Driver.8; also elsewhere on the board
