gj-prog2026/BalancingRobot/software/tests_LQR/after_adjusting_gyro_accel_ratio/dg_dump2.txt

//first// (inaccurate as bumped and leaned into a chair)
LOG rel*100,acc*100,gyro*10,enc_d,pwm
-76,-176,555,-38,999
-47,310,280,-41,999
-49,181,-18,-44,999
-74,313,-262,-47,999
-122,118,-485,-49,978
-189,112,-676,-51,787
-277,155,-881,-52,538
-377,-152,-1007,-50,274
-482,-422,-1051,-45,5
-593,-732,-1107,-41,-250
-642,-1615,-473,-32,125
-619,-1250,248,-27,767
-513,-368,1051,-28,999
-378,-88,1343,-34,999
-253,531,1237,-33,999
-190,166,622,-38,999
-156,368,324,-42,999
-154,96,23,-44,999
-176,488,-237,-47,999
-224,245,-491,-49,916
-294,233,-713,-52,719
-460,5326,-1770,-53,-496
-585,-661,-1250,-47,-205
-820,-253,-2360,-31,-999
-1115,4266,-3062,11,-999
-993,-1158,1232,24,51
-1041,185,-504,13,-999
-979,1,593,18,-444
-913,4152,563,26,-668
-882,107,285,21,-796
-821,41,591,25,-545
-736,184,836,29,-343
-636,1194,966,26,-44
-530,12,1045,21,262
-436,298,927,15,381
-342,298,927,12,536
-272,588,674,2,611
-294,712,-239,-2,-263
-363,661,-705,-3,-780
-490,62,-1285,3,-999
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
END

//second//
motors ENABLED
r=0 x=0 v=0 p=11 f=0 o=684 d=10
r=3 x=0 v=-1 p=134 f=0 o=684 d=10
r=6 x=0 v=-8 p=133 f=0 o=684 d=10
r=10 x=-1 v=-20 p=306 f=0 o=684 d=10
r=49 x=-2 v=-14 p=999 f=0 o=684 d=10
r=-6 x=-5 v=-1 p=-999 f=0 o=684 d=10
r=133 x=-6 v=-41 p=999 f=0 o=684 d=10
r=114 x=-12 v=-69 p=999 f=0 o=684 d=10
r=70 x=-20 v=-81 p=999 f=0 o=684 d=10
r=37 x=-29 v=-90 p=999 f=0 o=684 d=10
r=22 x=-38 v=-93 p=999 f=0 o=684 d=10
r=34 x=-48 v=-97 p=999 f=0 o=684 d=10
r=107 x=-57 v=-97 p=999 f=0 o=684 d=10
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
r=58 x=-29 v=-81 p=999 f=0 o=990 d=10
r=28 x=-37 v=-90 p=999 f=0 o=990 d=10
r=8 x=-47 v=-95 p=999 f=0 o=990 d=10
r=2 x=-57 v=-99 p=999 f=0 o=990 d=10
r=22 x=-66 v=-99 p=999 f=0 o=990 d=10
r=103 x=-76 v=-98 p=999 f=0 o=990 d=10
r=339 x=-86 v=-100 p=999 f=0 o=990 d=10
