gj-prog2026/BalancingRobot/(commit log)

2026-09-17 added related files from local directory on my laptop to GitHub directory
    [2nd layer.stl, base.stl, batt layer.stl, motor bracket 2.stl, motor bracket 3.stl, pcb_design1.kicad_pcb, pcb_design1.kicad_sch, top layer.stl]
2026-10-11 added the files for matlab simulation
    To test my hypothesis of robot lacking torque
2026-10-14 adjusted the model to achieve first successful balancing
    [dg_dump2.txt]
2026-10-16 Uploaded latest tests and reorganised the folder
    [dg_dump2.txt]
